jianzhisiyouqi/jzsyq/THIRD_PARTY_NOTICES.md

# 第三方与授权说明

本包包含自定义 RTL、Python/C 应用源码、Vivado 标准 IP 配置和构建产物。AMD/Xilinx IP、自动生成 wrapper 和构建文件保留原版权；完整 IP 实现由合法安装的 Vivado 生成，未把厂商 IP 或工具重新声明为项目原创代码。

PYNQ、NumPy、Pillow、pycparser 归各自权利人；本包不重新分发其安装包。屏幕初始化使用项目所附厂商四线 SPI 示例的参数配置，屏幕驱动器为 ST7796。未把供应商 PDF、示例压缩包或无关资料直接放入公开目录。

未自动为整包指定 MIT/GPL 等统一许可证；提交者需核对其原创贡献及第三方文件的公开授权范围。公开仓库不等于完成开源许可声明，也不替代参赛授权书。
