jianzhisiyouqi/jzsyq/docs/evidence/scan_native.png

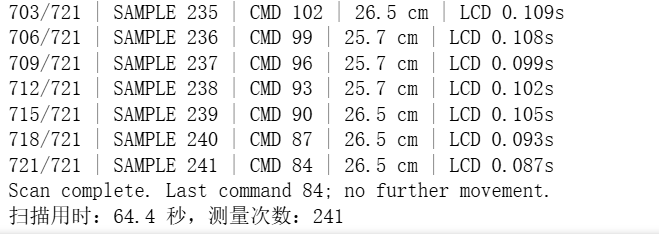
docs/evidence/scan_native.png
