jianzhisiyouqi/jzsyq/docs/WIRING.md

# 断电接线

硬件：PYNQ-Z2、HC-SR04 类模块、舵机、MB102、ST7796 3.5 英寸 LCD 与 35002 SPI 转接板。舵机具体型号未在当前材料中确认，不填造型号、电流或扭矩参数。

## PMODA

| 物理引脚 | FPGA 管脚 | 功能 |
|---|---|---|
| 1 | Y18 | 舵机 PWM 信号 |
| 2 | Y19 | 超声波 Trig |
| 3 | Y16 | 分压后 Echo |
| 5 | GND | 与外部供电共地 |
| 7 | U18 | 保留 OLED SDA，非本版 LCD 接口 |
| 8 | U19 | 保留 OLED SCL，非本版 LCD 接口 |

舵机与超声波使用外部 MB102 的 5 V，地与 PYNQ 相连，不将外部 5 V 接到 Pmod 信号或 3.3 V 电源针。

已采用的 Echo 分压：Echo → 1 kΩ → 1 kΩ → 分压点（接 PMODA 3）→ 1 kΩ → 1 kΩ → GND。理想 5 V 输入时分压点约 2.5 V；断电检查电阻连接及共地，不能以万用表的短时读数代替瞬态峰值保证。

## LCD 转接板 J1 到 PMODB

| LCD J1 针序 | 丝印 | PMODB 物理引脚 | FPGA 管脚 |
|---|---|---|---|
| 1 | VCC | 6，3.3 V | 电源 |
| 2 | GND | 5，GND | 地 |
| 3 | CS | 1 | W14 |
| 4 | RESET | 2 | Y14 |
| 5 | DC | 3 | T11 |
| 6 | SDI MOSI | 7 | V16 |
| 7 | SCK | 8 | W16 |
| 8 | LED | 9 | V12 |
| 9 | SDO MISO | 不接 | 写显示不需读回 |

针序以屏幕转接板 J1 从 VCC 起计算，不以示意照片左右方向猜测。LCD_CTRL 位 0=DC、位 1=RESET、位 2=背光控制。RESET 低有效；LED 是转接板背光控制输入，不是把背光电流直接接到 GPIO。LCD 的 VCC 与信号均按本版 3.3 V 连接，不接 5 V。触摸和 SD 卡端口不属于当前演示功能。

GPIO0 基址 0x40000000：DATA0 为测距 start，DATA8 为状态；GPIO1 基址 0x40010000：DATA0 为 Echo 计数，DATA8 为舵机指令；GPIO2 基址 0x41200000：LCD 控制。SPI 基址 0x41E00000。运行时以配套 HWH 解析地址，不靠手写地址替换其他设计。
