jianzhisiyouqi/jzsyq/(commit log)

2026-10-19 Add project overview and verified full engineering archive
    Publish the stable PYNQ-Z2 ultrasonic scanning project, third-party notices and SHA-256 manifest. The RAR contains RTL, Block Design, constraints, Python/C drivers, notebook, tests and matching bit/hwh.
2026-10-19 Add wiring guide and measured performance records
2026-10-19 Add ultrasonic echo counter and servo PWM RTL
2026-10-19 Add PYNQ-Z2 pin assignments and asynchronous timing constraints
2026-10-19 Add echo count and servo command GPIO IP configuration
2026-10-19 Add AXI Quad SPI IP configuration
2026-10-19 Add ultrasonic RTL module-reference configuration
2026-10-19 Add servo PWM module-reference configuration
2026-10-19 Add sensor status concat IP configuration
